dave980/cnc-control-files/cad/dust-extraction/README.md

# Dust extraction

Printable fittings for the shop's dust extraction — hoses, cuffs and adapters.
Separate from the mill's dust shoe, which is in `cad/dust-shoe/`.

3MF rather than STL, so each carries its own print settings.

| File | What |
|---|---|
| `2in-cuff.3mf` | 2 inch hose cuff |
| `2in-to-4in-adapter.3mf` | 2 to 4 inch step |
| `4in-coupler.3mf` | 4 inch coupler |
| `ryobi-cuff.3mf` | cuff for the Ryobi port |
| `ryobi-mitre-saw-hose-adapter.3mf` | mitre saw dust port adapter |

Every file was checked as a valid 3MF before committing: zip container, model
part present, CRCs intact.
