dave980/cnc-control-files/docs/tool-changer.md

# RapidChange ATC

Premium linear magazine, 6 pockets, ER20. `macros/tc.nc` began as RapidChange's
generated macro (see
[rvalotta/RapidChangeATC_FluidNC_M6_Macro](https://github.com/rvalotta/RapidChangeATC_FluidNC_M6_Macro))
and is modified for this machine. Driven through FluidNC's `m6_macro` hook — not the greilick-industries firmware fork, which is a
separate approach that replaces the macro entirely and has no `m6_macro` support.

## Coordinates

All in G53 machine coordinates. Machine Z0 is at the top, at the home switch.

| Tool | X | Y |
|---|---|---|
| 1 | −1211.400 | −85.400 |
| 2 | −1211.400 | −130.400 |
| 3 | −1211.400 | −175.400 |
| 4 | −1211.400 | −220.400 |
| 5 | −1211.400 | −265.400 |
| 6 | −1211.400 | −310.400 |

X and Y are negative because both home switches sit at the +end: X0 at the right-hand
switch (facing the front) with +X to the right, Y0 at the back switch with +Y to the
back. Both axes were flipped on 2026-10-19 so CAM output is not mirrored; before that
every X and Y here was positive, same magnitude.

Pitch 45.000 mm, base Y−85.400. Tool setter sits at **X−1211.000 Y−32.000** — it is
separate hardware that happens to share an X value with the pockets, so pocket
corrections do not move it.

**Manual tool changes happen at X−1100.000 Y−32.000**, 111 mm clear of the
magazine in X. Any tool outside 1-6 — T0, or anything above the magazine's
range — parks there at machine Z0 and waits on `M0`. It used to park at X0 Y0,
the home corner.

Near the magazine, but deliberately not over it, for two reasons. Nothing can
be dropped onto the tool setter, which is the one part here that has already
been broken once. And the working height is better: parked over the magazine
the nose has about 90 mm of clear space beneath it, because the magazine
occupies the bottom 50 mm — over bare spoil board it is the full 140 mm.

Offset in X rather than Y because Y−32 is already near the home end, and moving
the other way in Y runs into the pockets at Y−85.400.

**Machine Z0 is the ceiling.** The axis homes to the top and all travel is
negative from there, so the park is already as high as the machine goes. More
headroom can only come from the XY position, which is what the offset does.

| Z | Purpose |
|---|---|
| 0 | Safe / traverse |
| −68 | Tool recognition zone 2 |
| −74 | Tool recognition zone 1 |
| −82 | Approach, just above the nut |
| −105 | Full engagement |

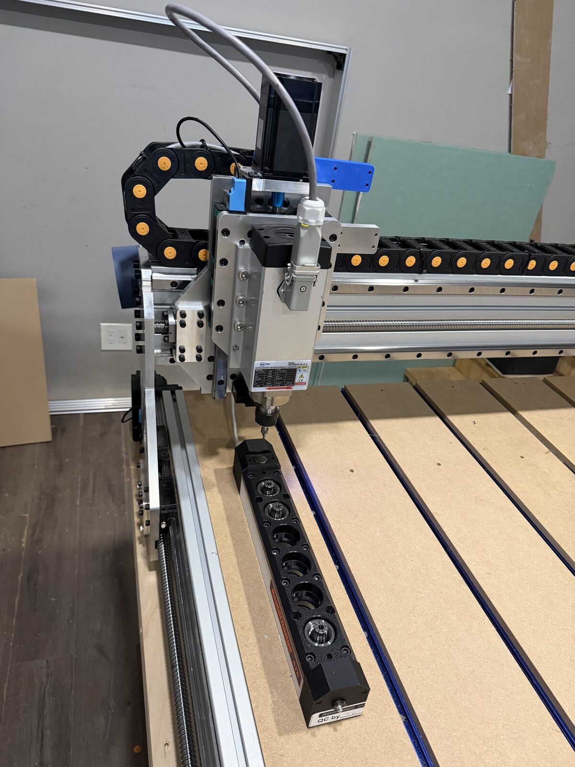
[picture p2: docs/images/spindle-and-magazine.jpg]
Spindle at the magazine


Six pockets in a line along Y, tool setter at the near end. The spindle nose is
at the top of its travel here, which is 90 mm clear of the magazine.

## Z geometry

Measured datums, both from the top of the spoil board:

- Bottom of the spindle, no collet, at Z−115: **25 mm**
- Top of the RapidChange magazine: **50 mm**

So spindle nose height above the spoil board = `25 + (115 + Z)`:

| Z | Nose height | vs magazine top | |
|---|---|---|---|
| 0 | 140 mm | +90 mm | safe / traverse |
| −68 | 72 mm | +22 mm | recognition zone 2 |
| −74 | 66 mm | +16 mm | recognition zone 1 |
| −82 | 58 mm | +8 mm | approach |
| **−90** | **50 mm** | **0 mm** | **clearance plane** |
| −105 | 35 mm | −15 mm | engagement |
| −115 | 25 mm | −25 mm | soft limit |
| −118 | 22 mm | −28 mm | rail end |

**Z−90 is the clearance plane over the magazine.** Above it the spindle passes
over the magazine freely; below it the nose is inside the magazine's envelope.

This verifies the macro geometrically: every XY move in `tc.nc` happens at Z0,
and the lowest the axis goes before an XY move is the −82 approach — both above
−90. The only travel below the clearance plane is the engagement plunge to
−105, which happens stationary over a pocket. Nothing traverses while the nose
is down inside the magazine.

Keep −90 in mind for any hand-written G-code that goes near X−1211. Crossing that
plane anywhere other than directly over a pocket is what a crash looks like.

## Speeds and feeds

| Setting | Value |
|---|---|
| Load | M3 S1800 (~1,830 rpm) |
| Unload | M4 S2100 (~2,130 rpm) |
| Engagement feed | F2000 |
| Probe seek | F600 |
| Probe set | F50 |

**Z travel is 115 mm and the engagement depth is 105 mm.** Ten millimetres of
clearance, which is the tightest margin on the machine. Consequences worth
keeping in mind: there is no room to deepen the pockets, a magazine remount that
sits any lower will not reach, and the soft limit at −115 is the only thing
protecting the bottom of Z since there is no lower limit switch.

**Z `max_rate_mm_per_min` must stay above 2000.** It was at 1500, which silently
clamped every engagement move to 75 % of the designed feed. It is now 2500.

The engagement feed is deliberately slower than synchronous. The ER20 nut is
M25×1.5, so at 1,830 rpm a synchronous feed would be ~2,745 mm/min. F2000 is about
73 % of that, and the shortfall is what makes the spindle thread pull itself into
the nut and seat it.

## Sequence

Load:

1. Rapid to the pocket, Z−82
2. `M3 S1800`, dwell 1 s
3. Four plunges between Z−105 and Z−93 at F2000 — threads the nut
4. `M5`, retract Z−74, read beam — must be **blocked**
5. Z−68, read beam again — must be **blocked**
6. `M61 Q<n>`, then probe the tool setter and `G43.1`

Unload:

1. Rapid to the pocket, Z−82
2. `M4 S2100`, dwell 1 s
3. Plunge Z−105, retract Z−93 — unthreads
4. Z−74, read beam — must be **clear**

## How tool length offsets work

The tool setter's height is never measured and never stored. It does not need
to be, and understanding why explains what can break it.

```
G38.2 G91 Z-75.000 F600.0    seek down fast until the setter trips
G38.4 G91 Z10.000  F50.0     back off slowly until it releases
G43.1 Z[#5063]               tool length offset = that position
```

`#5063` is the probe trip position. FluidNC fills `#5061`-`#5066` from
`steps_to_mpos()`, so it is in **machine** coordinates — the active work offset
cannot leak into the tool length offset.

At the moment of trip the tool *tip* sits at some fixed machine height, call it
T, which is a property of the setter and identical for every tool. The spindle
nose is then at `T + L` for a tool projecting L below the nose, so the offset
stored is `T + L`.

T is unknown and the stored offset is therefore "wrong" — but wrong by the same
constant for every tool, so tool-to-tool differences are exact. The constant
vanishes when work Z zero is touched off: it is absorbed into the G54 Z offset,
and from then on every probed tool puts its tip in the same place.

Accuracy comes from the F50 back-off, not the F600 seek. The seek only has to
land somewhere past the trip point.

### G53 ignores tool length offsets

Worth stating on its own, because it is why the macro works and it is a trap
when typing moves by hand.

`G53` skips the **whole** offset block — work offset and tool length offset
alike. So `G53 G0 Z-105` puts the **spindle nose** at machine Z-105 whatever is
in the collet. Every depth in this file describes the nose, not the tool tip,
which is exactly what the magazine needs: the pockets are at fixed heights and
the engagement depth must not change when a longer tool is fitted.

The same property bites in hand-written code. A `G53` Z move with a long tool
fitted puts the tip however far below the number you typed, and no offset
protects you.

Rule of thumb: **machine-fixed geometry uses `G53`** — pockets, the setter, the
dust shoe stand, park positions. **Cutting uses work coordinates** and plain
`G0`/`G1`, where the tool length offset is applied and the tip goes where the
program means.

`G53` is a modifier, not a motion command: it needs `G0` or `G1` already
active, or FluidNC returns `GcodeG53InvalidMotionMode`. Jogging is a third
thing again — `$J=`, which accepts only G90/G91, G20/G21 and G53.

### What breaks it

- **Touching off work Z zero without a measured tool.** The constant only
  cancels if a tool length offset was active when Z zero was set. Set it with
  no offset, or a stale one, and every tool afterwards is out by the difference.
- **Moving the setter.** Its height is baked into every work offset set since.
  Re-shim it, knock it, or remount the magazine and all existing work Z zeros
  are wrong by that amount, with nothing to indicate it.

Sanity check: the offset is negative, roughly -50 to -80 here, and a **longer**
tool gives a **less** negative value because it trips the setter sooner. A
longer tool reading more negative means something is inverted.

`findzposition.nc` is unrelated to any of this — it creeps up at F250 until the
IR beam breaks, to establish the magazine's tool recognition zones.

### A tool that is already loaded is still measured

`M6` for the tool already in the spindle used to return immediately:

```gcode
o1000 elseif [#<_selected_tool> EQ #<_current_tool>]
    (print, Current tool selected. Tool change bypassed.)
```

That is the first bullet above, reached by accident. The commonest way to hit
it is the ordinary one: power up, `M61 Q3` to tell FluidNC what is in the
collet, load a program whose first tool is 3. The macro bypassed, no probe
ran, no offset was set, and the first touch-off of work Z zero banked whatever
offset happened to be active — usually none.

Now the magazine is skipped but nothing else is. The bypass sets a flag:

```gcode
#<_rc_bypass> = 0
o1050 if [#<_selected_tool> EQ #<_current_tool>]
    #<_rc_bypass> = 1
o1050 endif
```

and the unload and load blocks each open with `if [#<_rc_bypass> EQ 1]`, which
is empty. So the spindle still parks the dust shoe, still clears the old offset
with `G43.1 Z0`, still runs `M61`, still probes the setter, still refits the
shoe and still returns to where the program was. Only the two trips to the
pocket are missing, because the nut never has to be touched.

It measures on **every** same-tool `M6`, not only the first. No state has to be
carried between programs for that, and CAM emits `M6` only at a tool change, so
in a real program the same-tool case *is* the first one. The cost of the extra
measurement is about eight seconds; the cost of not having it is a tool diving
through the work.

## The macro must not end over the tool setter

**This broke a tool and the setter on 2026-10-08.** It is the most dangerous
interaction found on this machine, and it is invisible in hand testing.

The macro used to finish with `G53 G90 G0 Z0.000` and hand control back with
the spindle still parked at X−1211.000 Y−32.000 — directly over the tool setter.
That is safe in itself, since machine Z0 is 140 mm above the spoil board. The
danger is the **next line of the program**.

Vectric emits an initial Z retract at the top of a file, so the first tool
change comes out as:

```
M6 T1
G0Z0.8000        <- work-coordinate Z move, still over the setter
G0X0.0000Y0.0000 <- only now does it move away
```

Z+0.8 inch is 20.3 mm above the work surface. On a 19 mm board that is about
39 mm above the spoil board, and the magazine top alone is 50 mm. The tool is
commanded to a height *below* the thing it is standing on, and gets there at
rapid.

Every later tool change in the same file is safe, because Vectric emits XY
before Z for those. Only the first one carries the trap, which is why hand
testing `M6` never reproduced it — nothing followed with a work-coordinate Z
move.

**Fix: the macro now returns to where it started.** `tc.nc` and
`measuretool.nc` record `#<_abs_x>` / `#<_abs_y>` before any motion and finish
with a `G53` move back:

```
G53 G90 G0 Z0.000
G53 G90 G0 X[#<_rc_start_x>] Y[#<_rc_start_y>]
```

Machine coordinates deliberately, not work. `#<_x>` would have worked too, but
a `G53` return stays geometrically correct even if the work offset is wrong —
and a wrong work offset is exactly the condition under which the next move is
dangerous.

This is a macro-side fix on purpose. Correcting the post would fix one post;
any CAM that emits a Z move before an XY move after `M6` sets the same trap.

### The general rule

**After `M6`, the first move must be XY, not Z.** If you ever write G-code by
hand or change post processors, check that. The machine cannot protect you here
— the soft limit at Z-115 is a machine-coordinate limit and the descent was
well inside it.

## Failure recovery

The macro uses `$Alarm/Send=3` as its abort signal. Alarm 3 is named "Reset while
in motion", which is misleading — nothing reset and no position was lost.

| Message | Meaning | Fix |
|---|---|---|
| Current tool not initialized | `current_tool` is −1 after a restart | `$X`, `M61 Q<n>`, retry |
| IR beam obstructed | Something in the beam at the start | Clear the magazine |
| Failed unload at zone 1 | Tool still on the spindle after unloading | Remove by hand, cycle start |
| Failed load at zone 1 | No tool detected after loading | Thread by hand, cycle start |
| Failed load at zone 2 | Tool detected at −74 but not −68 | Check the nut is fully seated |

Failures pause with `M0`. Fix the condition by hand, then **cycle start** — the
real-time character `~`, or the play button in the web UI.

`~` sent as a *line* from a different interface than the one running the job gets
rejected with "Another interface is busy". FluidNC gates lines needing the
protocol context by channel while a job runs. Send it as a raw character from the
interface that started the job, or use the web UI button.

## Dust cover — not connected

The Premium cover is two servos driven by a programmed ATtiny, with the blue wire
as its logic input. It is an **output** from the controller, not a sensor.

It never worked. What was established:

- gpio.46 (third 5 V output) delivers a clean 5.08 V on pin 2 under `M64 P1`
- The blue wire was confirmed on pin 2
- Unplugging the connector **opens** the cover, so the module idles its input high
- Driving 5.08 V into it does nothing
- The blue wire reads 2.55 V open-circuit — about half rail, a floating input, so
  there is no pull-up to a higher supply

The signal spec is not published. `user_outputs` is removed from the config and
the `M64 P1` / `M65 P1` lines are stripped from `tc.nc` and `measuretool.nc`,
because `M64` on an undefined output errors and aborts the macro.

**The cover has been physically removed from the magazine**, so there is nothing
for a tool to hit. If one is ever refitted, it must be driven or secured open
before running a tool change — `tc.nc` drives Z to −105 in the magazine.
