dave980/cnc-control-files/docs/images/breakout-panel-overview.jpg

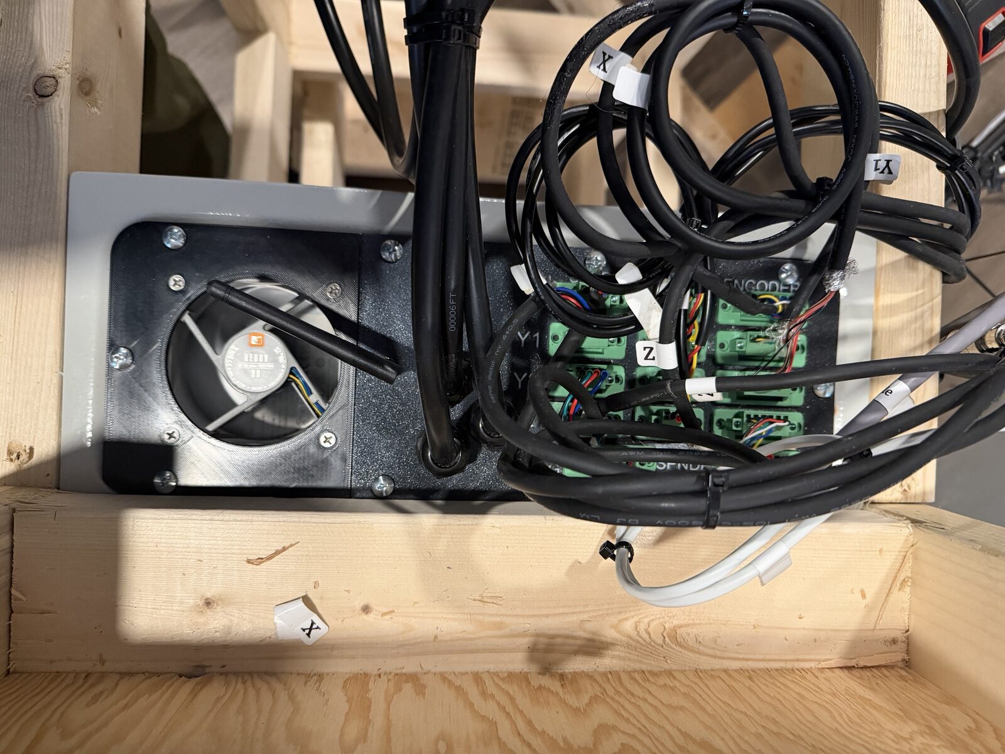
docs/images/breakout-panel-overview.jpg
