dave980/cnc-control-files/docs/images/gantry-overview.jpg

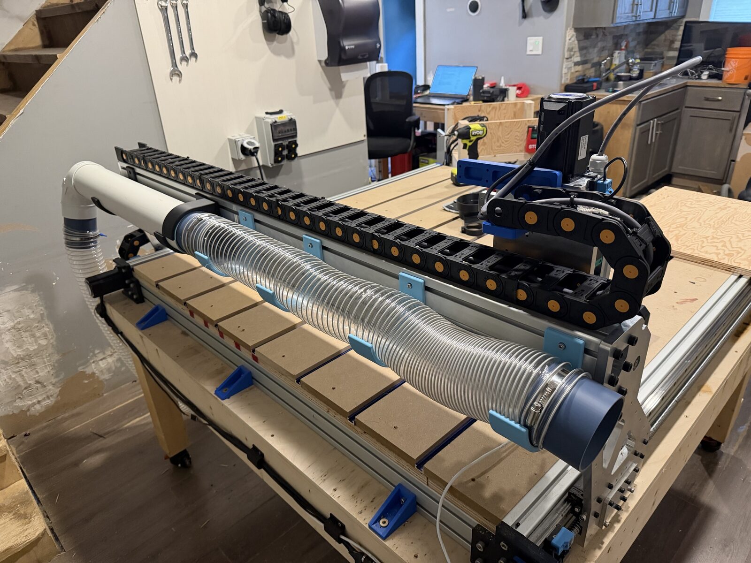
docs/images/gantry-overview.jpg
