dave980/cnc-control-files/docs/images/table-and-gantry-end.jpg

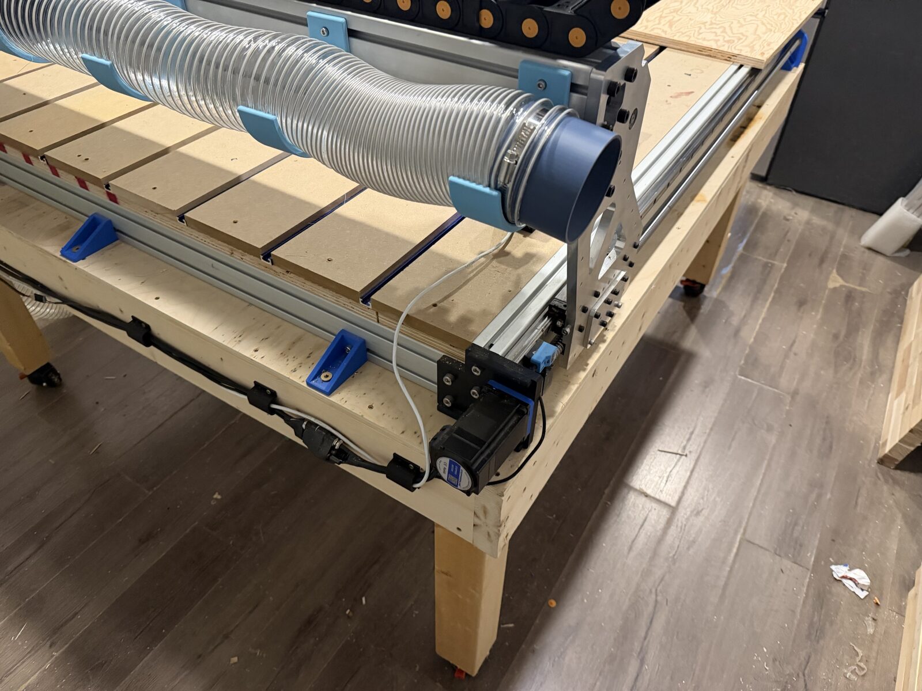
docs/images/table-and-gantry-end.jpg
