dave980/cnc-control-files/docs/images/y-axis-motor.jpg

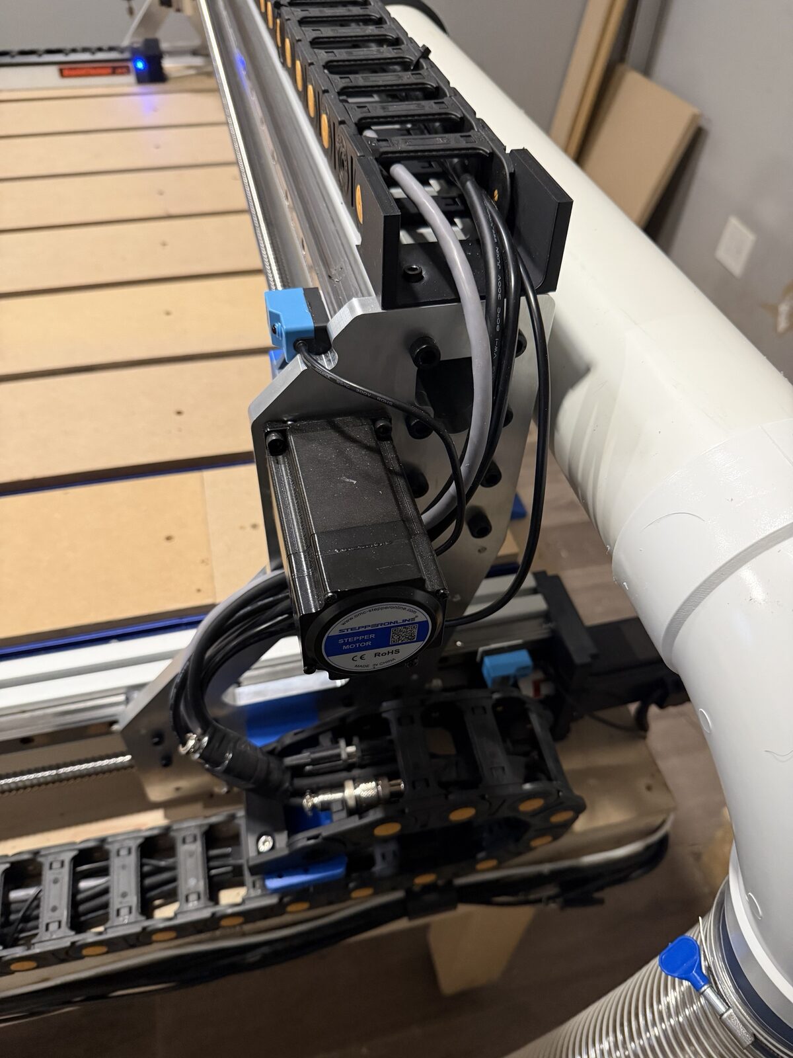
docs/images/y-axis-motor.jpg
