dave980/cnc-control-files/cad/dust-extraction/ryobi-mitre-saw-hose-adapter.3mf

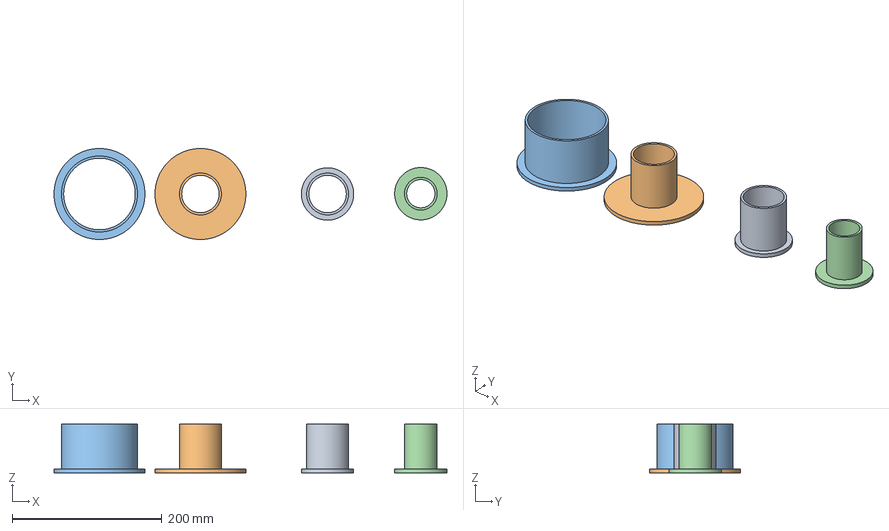
[picture p8: CAD file, 2026-10-25]
cad/dust-extraction/ryobi-mitre-saw-hose-adapter.3mf
525.5 x 121.6 x 65.0 mm
2in coupler
2in to 4in adapter
4in coupler
tool to 2in adapter
