dave980/cnc-control-files/cad/dust-shoe/print/hose-holder-rear.stl

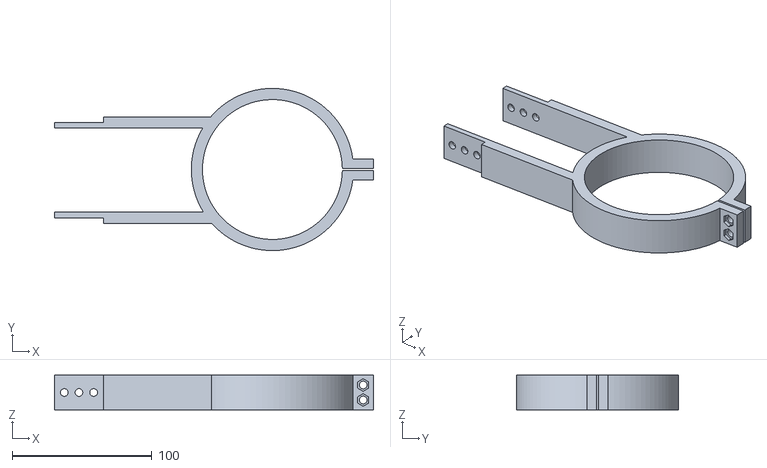
[picture p9: CAD file, 2026-10-25]
cad/dust-shoe/print/hose-holder-rear.stl
228.1 x 116.0 x 25.0
