dave980/cnc-control-files/cad/dust-shoe/stl/solid-brush.3mf

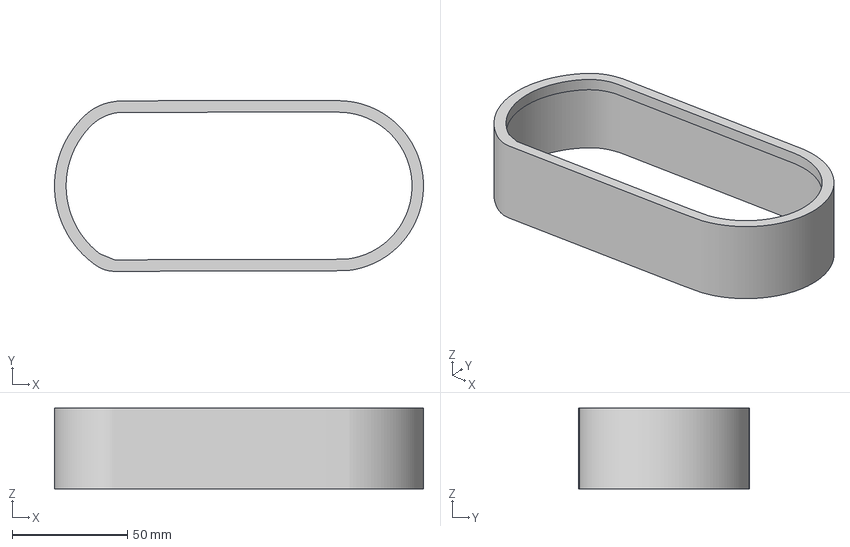
[picture p10: CAD file, 2026-10-25]
cad/dust-shoe/stl/solid-brush.3mf
160.3 x 74.1 x 35.0 mm
