dave980/cnc-control-files/cad/dust-extraction/body36.3mf

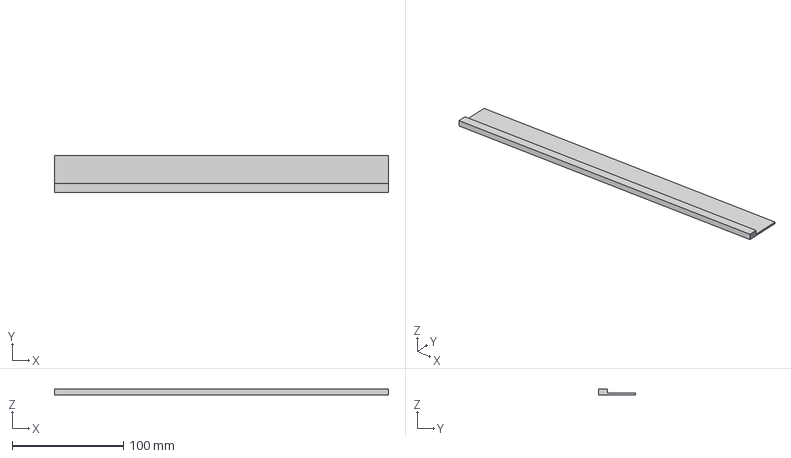
[picture p11: CAD file, 2026-10-25]
cad/dust-extraction/body36.3mf
300.0 x 33.0 x 5.00 mm
