dave980/cnc-control-files/cad/dust-shoe/print/spindle-holder-1.stl

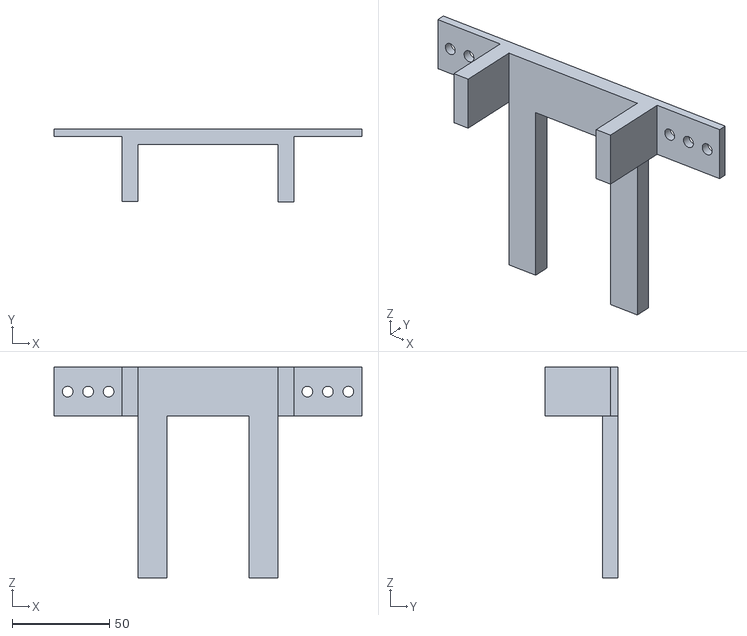
[picture p12: CAD file, 2026-10-25]
cad/dust-shoe/print/spindle-holder-1.stl
158.0 x 37.5 x 108.0
