dave980/cnc-control-files/cad/dust-shoe/stl/2in-to-4in-adapter.3mf

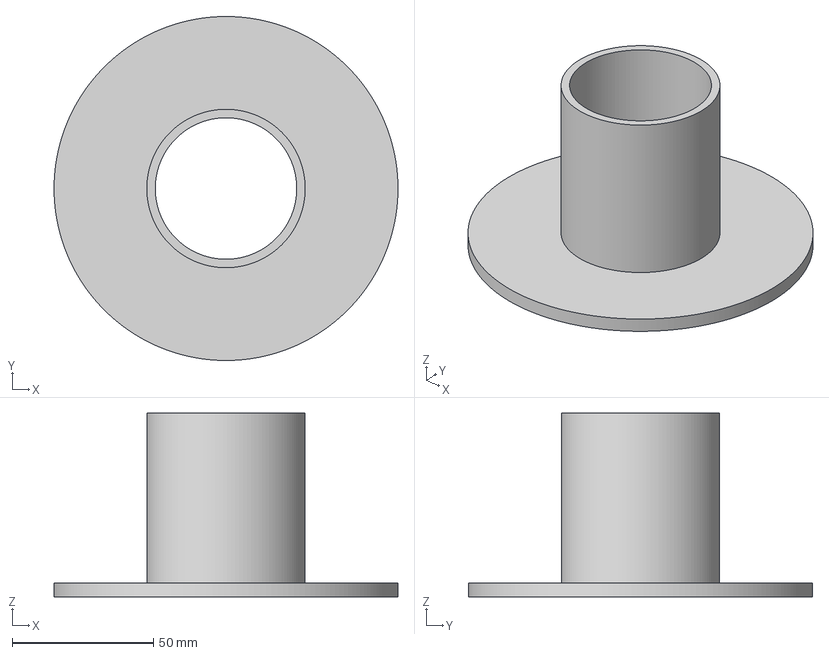
[picture p13: CAD file, 2026-10-25]
cad/dust-shoe/stl/2in-to-4in-adapter.3mf
121.6 x 121.6 x 65.0 mm
