dave980/cnc-control-files/cad/dust-extraction/2in-cuff.3mf

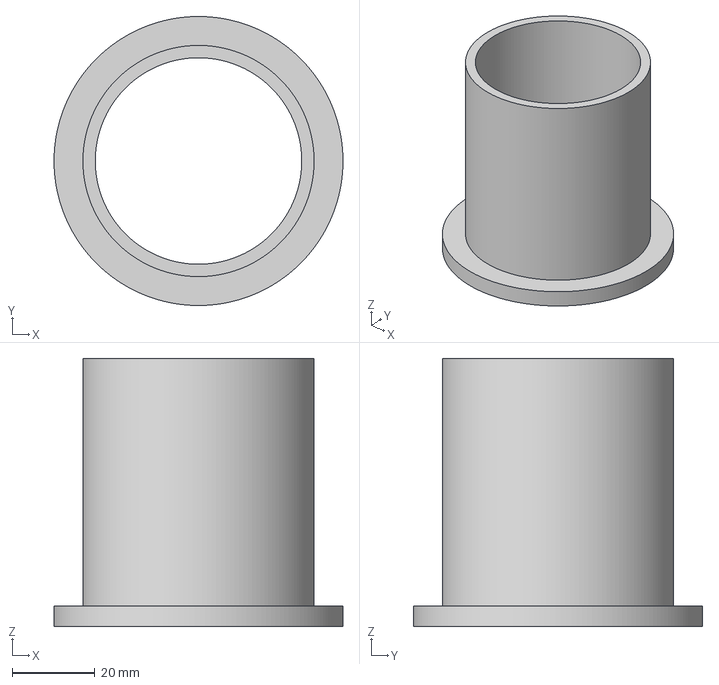
[picture p14: CAD file, 2026-10-25]
cad/dust-extraction/2in-cuff.3mf
70.0 x 70.0 x 65.0 mm
