dave980/cnc-control-files/cad/dust-shoe/print/hose-holder-front.stl

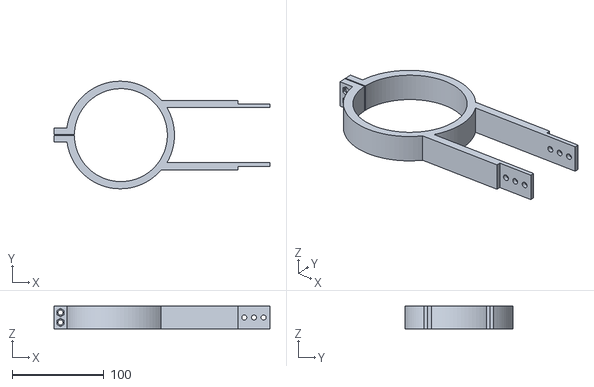
[picture p15: CAD file, 2026-10-25]
cad/dust-shoe/print/hose-holder-front.stl
235.7 x 117.5 x 25.0
