dave980/cnc-control-files/cad/dust-shoe/stl/ryobi-cuff.3mf

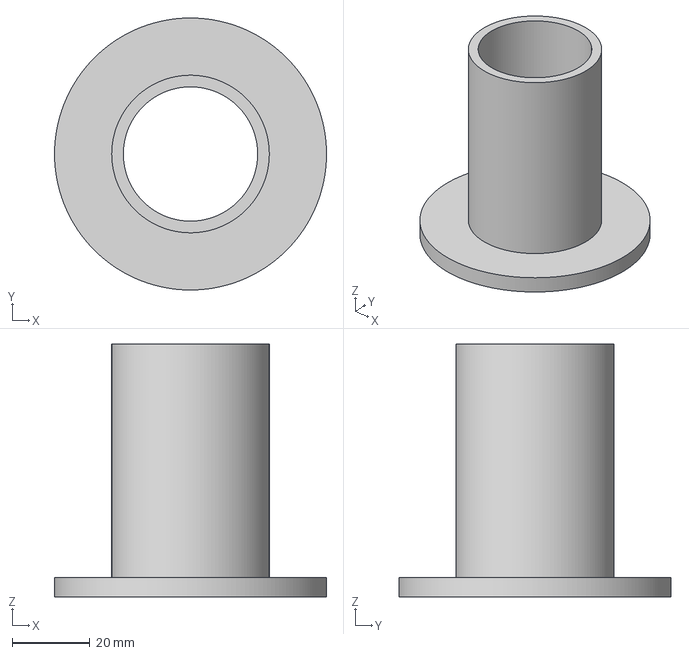
[picture p16: CAD file, 2026-10-25]
cad/dust-shoe/stl/ryobi-cuff.3mf
70.0 x 70.0 x 65.0 mm
