dave980/cnc-control-files/cad/dust-extraction/4in-coupler.3mf

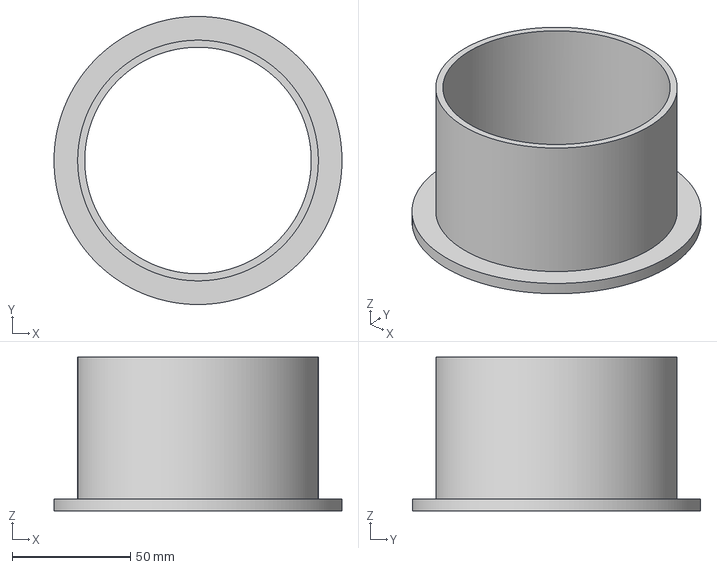
[picture p17: CAD file, 2026-10-25]
cad/dust-extraction/4in-coupler.3mf
121.6 x 121.6 x 65.0 mm
