dave980/cnc-control-files/cad/dust-shoe/stl/bottom-shoe.stl

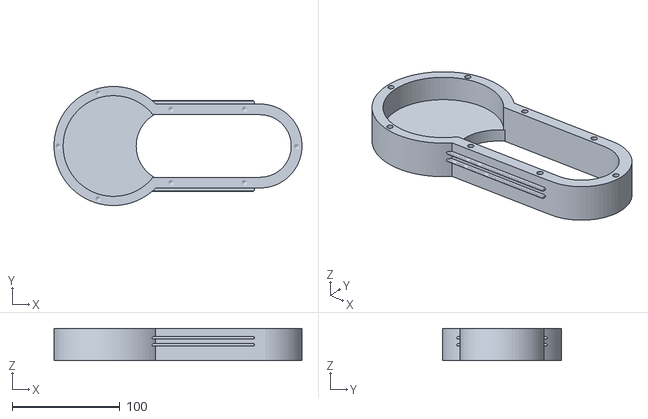
[picture p18: CAD file, 2026-10-22]
cad/dust-shoe/stl/bottom-shoe.stl
230.0 x 110.4 x 30.0
