dave980/cnc-control-files/cad/dust-shoe/stl/body21.stl

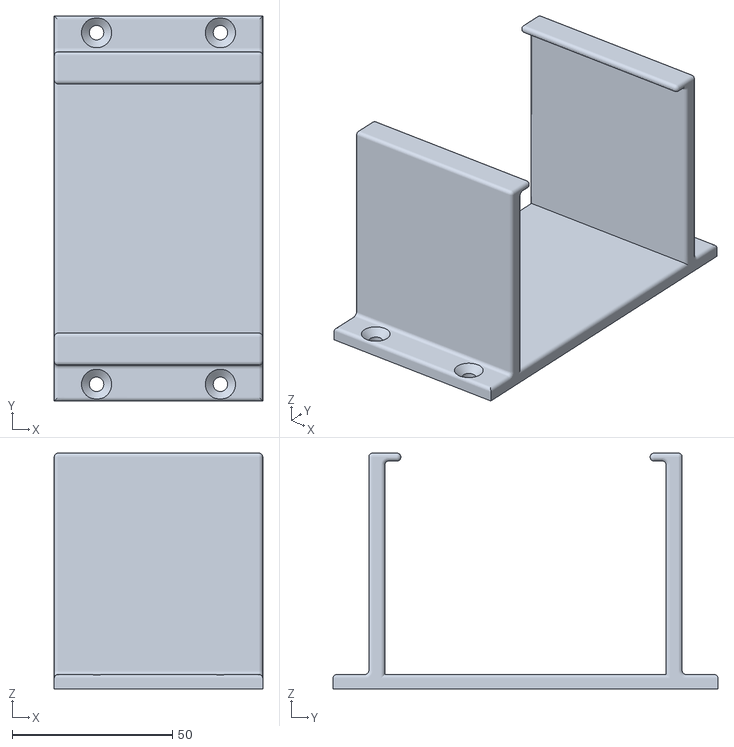
[picture p19: CAD file, 2026-10-22]
cad/dust-shoe/stl/body21.stl
65.0 x 120.0 x 73.5
