dave980/cnc-control-files/cad/dust-shoe/stl/body3.stl

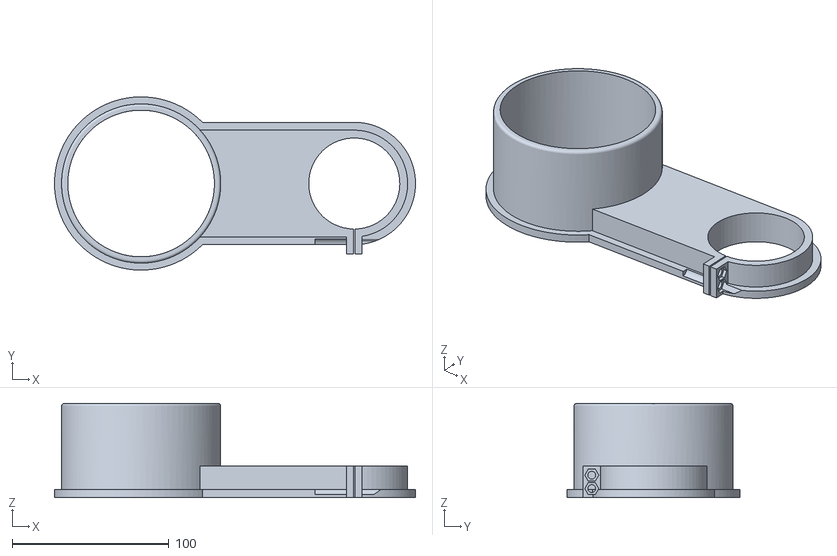
[picture p20: CAD file, 2026-10-22]
cad/dust-shoe/stl/body3.stl
230.0 x 110.4 x 60.0
