dave980/cnc-control-files/cad/dust-shoe/stl/body9.stl

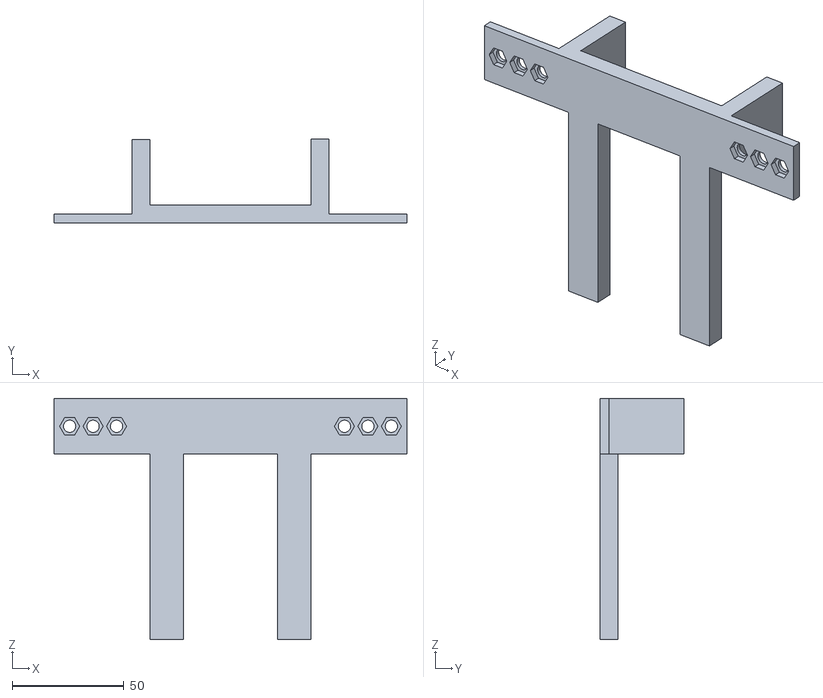
[picture p21: CAD file, 2026-10-22]
cad/dust-shoe/stl/body9.stl
158.0 x 37.5 x 108.0
