dave980/cnc-control-files/cad/dust-shoe/stl/body34.stl

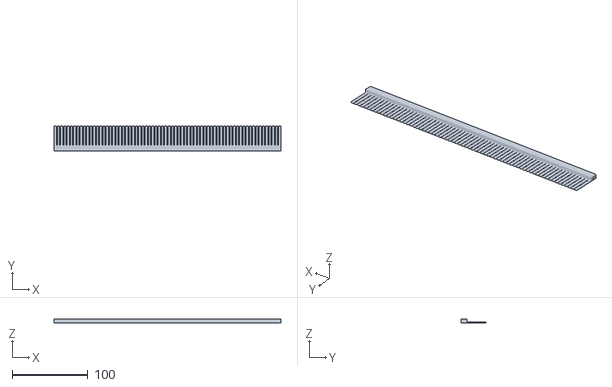
[picture p22: CAD file, 2026-10-22]
cad/dust-shoe/stl/body34.stl
300.0 x 33.0 x 4.75
