dave980/cnc-control-files/(list of files, cad)

Other CAD files:
cad/dust-shoe/stl/body8.stl
cad/dust-shoe/stl/body15.stl
cad/dust-shoe/stl/body27.stl
cad/dust-shoe/stl/body14.stl
cad/dust-shoe/cnc-dust-shoe.f3d
