dave980/cnc-control-files/docs/images/build-in-progress.jpg

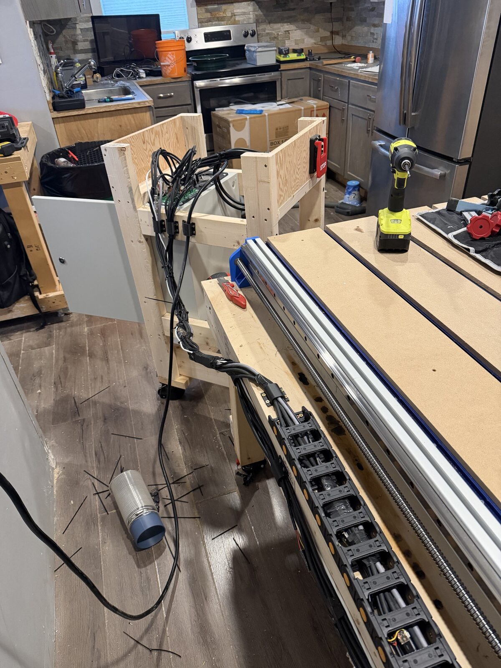
docs/images/build-in-progress.jpg
