dave980/cnc-control-files/(commit log)

2026-10-07 Doberman/FluidNC CNC config with RapidChange ATC
    Working configuration for a 3-axis mill (X, Y1, Y2, Z) on a Doberman board:
    endstops, homing, YL620-A spindle calibration and a RapidChange 6-pocket
    tool changer driven by tc.nc through FluidNC's m6_macro hook.
    Includes commissioning notes for the problems that were non-obvious: the
    opto-isolated input pins, the VFD's low-frequency V/F boost and analog
    floor, the clamped Z engagement feed, and macros living in internal flash
    rather than on an SD card.
    Claude-Session: https://claude.ai/code/session_01YatCWvVEQ2ouZGrFtucrQo
2026-10-07 Shift magazine and tool setter Y by +4.8 mm
    Measured on the machine: pocket 1 moved from Y80.6 to Y85.4 and the tool
    setter from Y27 to Y32. Both shifted by the same amount, so the 45 mm
    pocket pitch is unchanged — this is a whole-assembly offset.
    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
2026-10-08 Rename dobermann_config.yaml to config.yaml
    Board-agnostic name, and references in the README updated to match.
    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
2026-10-08 Corrections from the machine: Y drift fixed, 5 V endstops, cover removed
    - Y drift resolved. The left rail was out of parallel; loosening and
    re-torquing it with the gantry bolted to both carriages fixed it. Moved to
    Solved, with the ruled-out causes kept for the record.
    - Rails are MGN, not HGR.
    - Endstops run at 5 V, not 12 V. The Switch Vcc jumper is global and the tool
    changer needs 5 V, so both share it. Noted that 5 V sits at the bottom of the
    SN04-N range.
    - Dust cover is physically removed from the magazine, so there is nothing for a
    tool to hit. Softened the crash warning to apply only if one is refitted.
    - Magazine pitch left open, rewritten against the current coordinate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
2026-10-08 Correct the SN04-N voltage range
    These are specified 5-30 V DC, so 5 V is in spec at the bottom of the range,
    not below it as the previous note implied.
    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
2026-10-08 Correct rails to HGR20 and record the X/Y linear motion hardware
    X and Y run VEVOR HGR20-1500 rails with RM1605-1500 ballscrews and BF12/BK12
    end supports. The previous MGN reference in the Y drift entry was wrong.
    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
2026-10-08 Record Z rails and note the missing Z max_travel_mm
    Z runs HGR20 300 mm rails with four HGH20CA blocks, so the machine is HGR20
    throughout. Also noted that the Z axis declares no max_travel_mm, leaving the
    bottom of Z without soft limits.
    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
2026-10-08 Record the Z ballscrew and note that Z travel may be tight
    Z uses an SFU1605-350 with BK12/BF12 supports. Added a note that the 300 mm
    rails with two HGH20CA blocks per rail, not the screw, limit Z travel, and that
    the result may not sit far above the 105 mm tc.nc needs.
    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
2026-10-08 Set Z max_travel_mm to the measured 115 mm
    Z travel from the home switch measures 115 mm. Z has only a top limit switch,
    so the soft limit is the only protection at the bottom and it was previously
    unset. Noted the 10 mm of clearance over the tool changer's 105 mm engagement
    depth, which is the tightest margin on the machine.
    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
    [config.yaml]
2026-10-08 Record the reference measurement behind the Z soft limit
    Z-118 is where the carriage sits flush with the bottom of the rail; beyond that
    it overhangs and the balls lose support. The 115 mm soft limit keeps a 3 mm
    buffer before that point.
    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
2026-10-08 Add Z geometry and derive the magazine clearance plane
    Two measured datums from the spoil board — bare spindle nose at 25 mm when Z is
    at -115, magazine top at 50 mm — fix the whole Z geometry. Working it through
    gives Z-90 as the clearance plane over the magazine, which verifies tc.nc: every
    XY move happens at Z0 and the lowest pre-move position is the -82 approach, both
    above -90. Only the stationary plunge to -105 goes below it.
    Also noted that the Z soft limit does not protect the spoil board, since a
    fitted tool reaches it well before -115.
    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
2026-10-08 Add a deploy script for pushing config and macros to the controller
    tools/deploy.sh uploads to the controller's internal flash over FluidNC's HTTP
    API, verified against WebUIServer.cpp: POST /files for LocalFS, with the
    optional <filename>S size field so a truncated upload is caught.
    It refuses to upload unless the machine reports Idle, Alarm or Sleep, since an
    upload mid-job is bad and a $Bye mid-job is worse.
    docs/deploying.md explains why there is no direct GitHub-to-board path, shows
    the self-hosted runner option, and argues against automating the controller
    upload on every push.
    Claude-Session: https://claude.ai/code/session_01Yat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
2026-10-08 Fix deploy.sh argument parsing and the unworkable state check
    Two bugs found on review:
    - Argument parsing mishandled `BOARD=... ./deploy.sh --restart`, taking
    "--restart" as the address. Options and the address are now parsed
    separately, with an error on unknown options.
    - The idle check read the HTTP response of `?`, which never returns anything.
    FluidNC's /command endpoint only returns output synchronously for commands
    starting with [ESP or $/ — everything else goes to the websocket. The check
    would have failed every time and refused all deploys.
    Reachability is now verified with [ESP800], which does return over HTTP and
    confirms the target is FluidNC. Machine state is a hum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
2026-10-08 Add a PowerShell deploy script and Windows notes
    tools/deploy.ps1 mirrors deploy.sh using curl.exe, which ships with Windows 10
    1803+. Same gates: [ESP800] identity check, human confirmation of idle state,
    upload with the size field, then a /files listing.
    Documented that a git repo inside OneDrive is a bad idea — OneDrive syncs .git
    itself and can produce conflicted copies or cloud placeholders — and noted that
    CRLF is harmless here because InputFile::readLine skips \r. .gitattributes pins
    LF regardless, to keep diffs clean.
    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
2026-10-08 Credit the LienCNC-V2 design and the upstream software
    The machine is built from Eric Lien's LienCNC-V2 mechanical design. Credited by
    link rather than by forking, because this repository is not derived from his
    code: LienCNC-V2 ships a UCCNC .pro config while this machine runs FluidNC, so
    the config and macros here share no lineage with it.
    Noted that his repository carries no LICENSE file, so his CAD, drawings and BOM
    are all-rights-reserved by default and must not be copied in here.
    Also credited FluidNC and the Doberman board, RapidChange, and rvalotta's M6
    macro, which tc.nc is based on.
    Claude-Session: https://claude.ai/code/sess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
2026-10-08 Add photos of the machine and wiring
    Ten photos, resized to 1600px and stripped of metadata — 14 MB down to 3 MB.
    Named for what they show rather than their upload hashes.
    Placed where they explain something: the magazine shot in tool-changer.md
    beside the coordinates, the cabinet and breakout panel shots in wiring.md
    beside the pin tables.
    The cabinet photo also pinned down the supply models, which were previously
    recorded only as "48 V" and "12 V": Meanwell XDR-960E-48 and Lawlron NDR-120-12.
    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
2026-10-08 Add photos of the machine and wiring
    Eleven photos, resized to 1600px and stripped of metadata - 15 MB of originals
    down to 3.2 MB. Named for what they show rather than their upload hashes.
    Placed where they explain something rather than in a gallery: the full machine
    leads the README, the magazine shot sits beside the coordinates in
    tool-changer.md, and the cabinet and breakout panel shots sit beside the pin
    tables in wiring.md.
    The cabinet photo also pinned down the supply models, previously recorded only
    as "48 V" and "12 V": Meanwell XDR-960E-48 and Lawlron NDR-120-12.
    Claude-Session: https://claude.ai/code/session_01YatCWvVEQ2ouZG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
2026-10-08 Document the emergency stop, and de-duplicate the docs
    Two commits of the same work landed earlier, leaving README.md with two Credits
    sections and two hero images, and wiring.md with two "The hardware" sections.
    Merged rather than deleted: the Credits section keeps the fuller account of the
    LienCNC-V2 licensing position plus the specific macro modifications from the
    other version.
    The E-stop is hardwired and cuts motor and spindle power while deliberately
    leaving the Doberman powered, which keeps the WebUI and config and avoids the
    current_tool reset. The consequence is that FluidNC does not know it fired, so
    MPos is stale and nothing alarms - hence re-home after every E-stop, noted in
    bot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
2026-10-08 Plan the CL57T alarm wiring on gpio.37
    gpio.37 is free since the dust cover was abandoned, and it is an opto input in
    the same header block as the limit switches.
    Documented that ganging the four ALM outputs depends on their rest state:
    parallel ORs a normally-open output, but would AND a normally-closed one and
    require all four to fault. Series/NC is preferable where supported because a
    broken wire then raises the alarm instead of silently removing the protection.
    Added the control: section to config.yaml commented out, with both polarities
    noted, plus a two-stage test: short the pin to check the config, then force a
    real driver fault.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
    [config.yaml]
2026-10-08 Add a read-only VFD parameter dump over Modbus
    tools/vfd_dump.py sweeps the YL620-A's parameter space over Modbus RTU and
    writes a markdown table. It issues only function code 03, so it cannot change
    the drive's configuration.
    The register mapping is Pgg.ii -> (gg * 256 + ii), which the YL620 manual does
    not document. It is derived from FluidNC's own YL620 driver, which reads two
    registers from 0x0308 and decodes them as min/max RPM - 0x0308 and 0x0309 being
    P03.08 and P03.09.
    CRC16 verified against three canonical Modbus test vectors. The pyserial import
    is deferred so --help works without the dependency installed.
    Claude-Session: htt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
    [vfd_dump.py]
2026-10-08 Record the RS485 adapter used for the VFD dump
    DSD TECH SH-U11F - isolated, FTDI, screw terminals - with the reasoning for
    picking an isolated one in this cabinet, and the wiring detail.
    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
2026-10-08 Note that spindle control stays on 0-10 V, not Modbus
    Bart Dring recommends 0-10 V over RS485 for this board, and the reasoning holds:
    an analog voltage has no protocol to fail, while Modbus control adds a failure
    mode that does not otherwise exist - a dropped link mid-cut leaves the drive
    doing whatever P03.03 dictates. The control registers stay documented for
    reference, with RS485 used only for read-only parameter dumps.
    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
2026-10-08 Record the magazine verified at all six pockets
    All six pockets exercised over repeated tool changes, so the 45.000 mm pitch
    and Y85.400 base are confirmed. The 0.4 mm discrepancy seen earlier between
    pockets 1 and 6 was measured while the Y rail was still binding — it was the
    drift, not a pitch error.
    Move that entry out of Open and repopulate Open with what genuinely remains:
    the CL57T ALM outputs nothing reads, the E-stop FluidNC never hears about, and
    the VFD dump waiting on the adapter.
    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
2026-10-08 Drop the 0.4 mm pocket discrepancy note
    It was poor centring of the spindle over the pocket when the measurement was
    taken, not rail binding, and the pitch was never in question — so the note
    explains nothing worth keeping.
    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
2026-10-08 Correct the ALM wiring for a single-ended alarm pin
    The CL57T brings out one ALM pin, not a floating ALM+/ALM- pair, so the output
    returns through the driver signal common. That rules out the series chain the
    previous note preferred: four single-ended outputs sharing one reference can
    only be paralleled, and parallel fails silent on a broken wire.
    Also note that polarity has to be measured rather than assumed - published
    descriptions of this output contradict each other - and what to do if it turns
    out to source rather than sink.
    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
2026-10-08 Add the ENA/ALM/BRK group common and the 48 V pre-check
    The driver groups ENA, ALM and BRK as single-ended signals, so they share a
    common that the ALM return has to land on - and it is not necessarily the
    step/dir return. Added the check that matters before connecting: if that
    common sits near 48 V it is referenced to the motor supply, and a direct wire
    would put 48 V across a 5 V opto input.
    Also flag BRK, which is adjacent, is also an output, and asserts during normal
    operation - so wiring it by mistake reads as a config fault.
    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
2026-10-08 Record the CL57T pinout from the driver label
    Control connector is PUL+/- DIR+/- ENA+/- ALM BRK COM-, so enable is a
    differential pair and ALM/BRK are the only single-ended signals, with COM- as
    their shared emitter common. That settles the return path: ALM to gpio.37,
    COM- to the input header GND.
    Two things this changes. COM- is the driver's internal logic common and
    probably the power ground, so wiring it to the Doberman may bond the 48 V
    negative to logic ground - a star-ground decision, not just a signal. And the
    fail-safe question is not series-vs-parallel but which way the output rests:
    conducting-when-healthy is the fail-safe sense but ANDs rather than ORs when
    paralleled, which nee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
2026-10-09 Replace the ALM meter test with a firmware read
    A voltmeter cannot resolve an open-collector output with nothing pulling it
    up, and an ohmmeter on a powered circuit is unreliable - so the documented
    meter test would not have answered the question. gpio.37 already has the
    pull-up needed: wire one driver, read it through user_inputs with M66, force
    an alarm, read again.
    Reading it as a plain input rather than fault_pin keeps the test repeatable -
    fault_pin raises a critical alarm that only a soft reset clears, and that
    resets current_tool to -1.
    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
2026-10-09 Fix the stale COM- claim in the ALM intro
    The intro predated the driver label and said the alarm returned through the
    common the step/dir pairs already share. It does not - COM- is its own
    terminal and needs its own wire. Also stop presenting parallel as settled,
    since whether it ORs or ANDs depends on a measurement not yet taken.
    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
2026-10-09 Explain how tool length offsets work
    The tool setter's height is never measured or stored. Records why that still
    gives exact results - the trip height is a constant common to every tool, and
    it is absorbed into the work offset when Z zero is touched off - and the two
    things that break the chain: touching off Z zero without a measured tool, and
    moving the setter after work offsets exist.
    Confirms from FluidNC's Parameters.cpp that #5061-#5066 come from
    steps_to_mpos(), so the probe result is in machine coordinates and the active
    work offset cannot contaminate the tool length offset.
    Claude-Session: https://claude.ai/code/session_01YatCW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
2026-10-09 Return to the starting XY instead of parking over the tool setter
    A program's first M6 broke a tool and the setter. tc.nc finished with the
    spindle still at X1211 Y32, over the setter, and Vectric emits an initial Z
    retract before any XY move - so the next line, G0 Z0.8, drove the tool back
    down into the setter at rapid. Z+0.8in is ~39mm above the spoil board on a
    19mm board; the magazine top alone is 50mm.
    Only the first tool change in a file is exposed, since later ones emit XY
    first. That is why hand-running M6 never reproduced it.
    tc.nc and measuretool.nc now save #<_abs_x>/#<_abs_y> before any motion and
    return there with G53 after retracting. Machine coordinates on purpose: the
    retur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
2026-10-11 Add --list to vfd_dump.py and explain Windows error 121
    Opening COM5 failed with 'The semaphore timeout period has expired' - error
    121, raised at open() before anything reaches the VFD, so it is a host/adapter
    fault and not a wiring, baud or polarity one.
    --list prints the ports actually present with USB vendor IDs, which separates
    a wrong COM number from a ghost registry entry from a USB fault. The open
    failure now also catches OSError (121 arrives as OSError, not SerialException,
    so it was previously an untrapped traceback) and prints what to check.
    Both paths tested against a stubbed pyserial, since it cannot be installed in
    this environment.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
    [vfd_dump.py]
2026-10-11 Record COM3 as the adapter, and Bluetooth ports as the error 121 cause
    COM5 was a 'Standard Serial over Bluetooth link'. Windows tries to raise an
    RFCOMM connection to a device that is not paired, waits, and times out - which
    is exactly how error 121 surfaces. Those ports exist whether or not anything
    is paired, so they look like real candidates.
    The SH-U11F is COM3 on this laptop, 0403:6001.
    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
2026-10-11 Add .gitattributes to pin line endings
    The working copy is Windows but deploy.sh runs under bash, where CRLF makes
    the interpreter line unparseable. Pin .sh to LF, .ps1/.cmd to CRLF, and the
    files that get uploaded to the controller to LF.
    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
2026-10-11 Correct four VFD values against the dump, and flag the overload setting
    P06.01/P06.02 were recorded as 9 s and 8.6 s and P12.19 as 13 kHz. The drive
    holds 5.0 s, 5.0 s and 8.0 kHz - the earlier numbers were the setup table's
    suggestions copied in rather than read off the drive. The machine was always
    right; only this file was wrong.
    The dump also confirms what could not be verified before: P00.04 = 4000
    validates the register mapping and 0.1 Hz scaling independently, P03.12 = 0
    confirms the low-speed fix on the drive, P07.08 = 3 confirms analog input 1 is
    the frequency source, and P12.02 = 2 poles is what makes 400 Hz = 24000 rpm.
    Flagged but not changed: P12.00 rated motor current reads 1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
    [vfd_dump.py]
2026-10-11 Nameplate says 6 A: P12.00 is set at 15.0 A, 2.5x the spindle rating
    Photographed the spindle nameplate. 220 V, 400 Hz, 24000 rpm, 2.2 kW, 6 A,
    2 poles - the poles and the V/F figures match the drive, the current does not.
    P12.00 holds 150 (15.0 A), the same as P12.05 the converter rating, so the
    motor figure was evidently never set.
    That leaves the thermal overload unable to act before the windings are in
    trouble, and it matters most at the bottom of the range where the 20% V/F
    boost pushes current through a spindle whose fan is barely turning.
    Recorded the fix but did not touch P12.01 or P01.04: rated motor voltage
    scales the V/F curve on this kind of drive, and shifting it would disturb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
2026-10-11 P12.00 corrected to 6.0 A, units confirmed on the panel
    The panel reads 6.0, which also settles the 0.1 A scaling for this parameter -
    it had been inferred from P12.05 rather than documented.
    Moves the VFD dump out of Open, since it is done and cross-checked, and
    replaces it with the two things it left behind: a tool change has not been run
    since the overload was tightened 2.5x, and vfd-parameters.md still records the
    old 150.
    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
2026-10-11 P12.00 at 6.0 A stops the spindle starting - reverted
    Setting the rated motor current to the 6 A nameplate value left the spindle
    unable to turn at all on a tool change. P12.00 is not only a thermal
    threshold: P01.03 and P01.04 are percentages of it, so 140% and 200% fell
    from 21 A and 30 A to 8.4 A and 12 A. An induction motor needs several times
    rated current to break away, so the drive clamps before the spindle develops
    starting torque.
    That was missed when the change was recommended - P12.00 was treated as one
    protection value rather than the scaling base for the whole group.
    The underlying problem stands: at 15.0 A the overload cannot protect a 6 A
    spindle. A real fix has to raise the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
2026-10-11 Err11 is motor overload: correct the mechanism and add the fault code table
    The drive reported Err11, motor overload - the overload model, not an
    overcurrent clamp. The earlier explanation blamed P01.03/P01.04 and was wrong.
    P01.05 is the overload threshold as a percentage of P12.00: 130% of 15.0 A is
    19.5 A, but 130% of 6.0 A is 7.8 A, which a 2.2 kW spindle exceeds getting
    moving.
    That also means the drive cannot both allow a boosted low-speed start and
    protect a 6 A motor, since one percentage governs both - raising P01.05 to
    permit the start gives most of the protection back. Recorded an intermediate
    P12.00 and a clamp-meter measurement as the honest options.
    Added the manual's fault c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
2026-10-11 P12.00 stays at 15.0 A: the nameplate value cannot be used
    10.0 A failed to start as well as 6.0 A. Three data points put the starting
    requirement between 13 A and 19.5 A - two to three times the 6 A nameplate,
    which is ordinary for an induction motor. What matters is that the drive's
    overload trips on it despite P01.06 nominally allowing 120 s, so it is not a
    slow thermal integral and cannot be set near the nameplate.
    One parameter serves both the starting allowance and the sustained limit, and
    the start sets a floor around 15 A. The V/F boost that made tool-change speeds
    possible is what drives the current, so backing it off would trade the
    low-speed capability the tool changer depends on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
2026-10-14 Record that only one opto input is free, and how to wire the ALM
    gpio.37 is the only free input - 36 is the probe, 38 the IR beam, 39-42 the
    limits, and the 5V outputs sit behind a buffer and cannot be read. So
    fault_pin and estop_pin cannot both have a pin, which the previous snippet
    implied they could.
    The ALM gets it: a driver faulting on position error is invisible to FluidNC
    today, while the E-stop already cuts power and signalling it only corrects the
    position display afterwards.
    Added the physical wiring, and why sharing the pin costs the fail-safe
    property - an NC E-stop contact rests closed and opens on press, the opposite
    sense to an ALM that pulls low on alarm, so sharing forces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
2026-10-15 Manual tool changes happen over the tool setter, not at X0 Y0
    Both out-of-range branches in tc.nc parked at the home corner. They now park
    at X1211.000 Y32.000, over the setter, which is where the macro probes
    immediately afterwards - so a hand-fitted tool is measured without moving and
    nothing traverses with a tool of unknown length.
    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
2026-10-15 Offset the manual change park 111mm clear of the magazine
    X1100 Y32 rather than directly over the tool setter. Nothing can be dropped
    onto the setter, and the usable height improves: over the magazine the nose
    has ~90mm beneath it since the magazine occupies the bottom 50mm, where over
    bare spoil board it is the full 140mm.
    Offset in X because Y32 is already near the home end and the other direction
    runs into the pockets at Y85.4.
    Z was already at the ceiling - machine Z0 is the top of travel - so the extra
    headroom could only come from the XY position.
    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
2026-10-19 Add dust shoe CAD: Fusion archive and per-body STLs
    Claude-Session: https://claude.ai/code/session_01EaHTYpXKr5mP7WEdGgcA2C
2026-10-19 Add dust shoe load/unload macros
    Magnetic shoe parks in the spoil-board stand: unload slides it onto the
    flanges and lifts off the magnets, load descends slowly and slides out.
    Positions are placeholders; both macros alarm until ds_park_x is set.
    Load pauses on M0 for a person to confirm the shoe is in the stand.
    Wired to WebUI macro buttons 2/3 and added to both deploy scripts.
    Claude-Session: https://claude.ai/code/session_0154KYwruiBaGSwdv9L3aWzM
2026-10-19 Dust shoe: stand is at X1210 Y610, slide is along Y
    Corrected: the shoe slides along Y from Y730 to Y610 at X1210, not along
    X. The whole 120 mm slide is now at F1000; the rapid-then-feed approach
    was only needed for the old 600 mm move.
    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
2026-10-19 Dust shoe macros: fix two broken slide lines; correct how they're run
    The previous edit's regex joined the slide move onto the line above in
    both standalone macros, leaving an unbalanced expression. Restored them
    as single G1 slides. Also corrected the docs: macro2/macro3 are FluidNC
    numbered macros run with $Macros/Run=N, not WebUI buttons.
    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
2026-10-19 Dust shoe: engage Z -87.5 (was -90)
    Slide height and magnet-seat height corrected to Z -87.5; the 15 mm
    slow lift/descent now runs between -87.5 and -72.5. Same change in
    tc.nc and both standalone macros.
    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
2026-10-20 Flip Y so +Y points to the back (fixes mirrored Vectric output)
    Y homed to the back as Y0 with +Y toward the operator, which made the
    machine's XYZ the mirror of CAM's convention: every Vectric job came out
    mirrored front-to-back. Now:
    - Y homing positive_direction: true, still mpos 0 at the back switches
    - Y1/Y2 switches moved from limit_neg_pin to limit_pos_pin (same wiring)
    - Y1/Y2 direction pins uninverted (dropped :low)
    - Every G53 Y in tc.nc, measuretool.nc and the dust shoe macros negated:
    pockets -85.4..-310.4, setter/manual change -32, shoe -610/-730.
    Same physical positions.
    - Docs updated; envelope is now X 0..1220, Y 0..-1200, Z 0..-115.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
2026-10-20 Flip X as well: +X right, +Y back, facing the front
    The X switch is on the right as you face the machine, so +X ran left.
    With the earlier Y-only flip that left the machine mirrored. Now:
    - X homing positive_direction: true, mpos 0 at the right-hand switch
    - X switch moved from limit_neg_pin to limit_pos_pin (same wiring)
    - X direction pin uninverted (dropped :low)
    - Every G53 X in tc.nc, measuretool.nc and the dust shoe macros negated:
    pockets -1211.4, setter -1211, manual change -1100, shoe -1210.
    - Envelope X 0..-1220, Y 0..-1200, Z 0..-115; all axes home positive.
    Claude-Session: https://claude.ai/code/session_0154KYwruiBaGSwdv9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
2026-10-20 Spindle: off_on_alarm true; log false X hard-limit trip
    A spurious X limit trip mid-job stopped the axes but left the spindle
    running at 18000 rpm. Any alarm now also stops the spindle.
    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
2026-10-20 Docs: false X limit trip traced to a bad X sensor wire, fixed
    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
2026-10-22 Document jog soft-limit behaviour - it differs from program moves
    The overrun was a jog, and jogs take constrain_jog() rather than
    invalid_line(): a program move out of range is rejected whole, a jog is
    clamped and simply stops at the boundary with no alarm.
    Outside the envelope the rules change again - further-out jogs are cancelled
    unless a switch is active, and then capped at the pull-off, which is
    unset here so FluidNC's 1.0mm default applies.
    All of it logs at Debug and nothing higher, so at the default message level a
    clamped or cancelled jog looks like a jog that did nothing - the same trap
    that stretched out the M6 hunt.
    Claude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
2026-10-22 Note that G53 ignores tool length offsets
    It is why the magazine depths are correct for every tool - they describe the
    spindle nose, not the tip - and it is the trap when typing G53 Z moves by hand
    with a long tool fitted.
    Also records that G53 is a modifier needing G0/G1 active, and that jogging is
    a separate path via $J=.
    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
2026-10-22 Add a surfacing program generator
    tools/surface.py writes a flattening program from length, width and depth.
    Raster along X, stepping over in Y, alternating direction, with the cutter
    overhanging every edge by its radius plus a lead so nothing is left proud at
    the boundary, and the plunge happening off the corner in air.
    Depth and stepover are both distributed evenly rather than leaving a thin
    final pass - 1.5mm at 0.5 max becomes three passes of exactly 0.5, and a 300mm
    width with a 10.16mm maximum becomes 30 of exactly 10.0.
    Coverage was verified rather than assumed: the generated path was checked
    against a 0.5mm grid over the full board with no uncovered points, and the
    deepest Z confir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
2026-10-22 Surfacing: account for insert corner radius, and say tool diameter is unknowable
    The flat part of a cutter with rounded inserts is tool_dia - 2R, and that, not
    the diameter, is what limits stepover. --corner-radius computes the ridge left
    between passes from the corner arc, and refuses outright when the stepover is
    wide enough that the periphery cannot reach between passes.
    The default 0.4 stepover is far inside the limit so normal use is unchanged;
    this matters when pushing stepover up to shorten a long job, which is when
    tramlines appear for no obvious reason.
    Also documented that nothing on the machine knows tool diameter - FluidNC has
    no tool table, M61 records a number and the setter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
2026-10-22 Surfacing: prompt for values, and a double-clickable launcher
    Run with no options and it asks for everything, Enter accepting each default.
    Bad combinations re-prompt with the previous answers as defaults rather than
    quitting. Both routes produce byte-identical output - verified by diffing the
    prompt-driven file against the flag-driven one - and the coverage check still
    passes over the full board.
    tools/surface.cmd is the double-clickable front end for Windows, finding
    python or py and pausing so the summary stays readable.
    For a machine without Python, .github/workflows/surface-exe.yml builds a
    standalone surface.exe on a Windows runner, since PyInstaller cannot
    cross-compile. It smoke-te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
2026-10-22 Tidy: untrack bytecode, fix deploy.cmd restart flag, widen .gitignore
    The .pyc files under tools/__pycache__ were committed by accident when I used
    git add -A after importing surface.py in a test. They regenerate on every run
    and will show as modified forever, so they are untracked now and ignored.
    deploy.cmd had been edited locally to always restart the controller, which is
    a sensible default, but with '--restart'. deploy.ps1 declares [switch]$Restart,
    so PowerShell would have rejected '--restart' as an unbindable positional
    argument and the deploy would have failed. Now passes -Restart.
    .gitignore also now covers generated programs at the repo root, scoped as
    /*.nc so the tracked macros/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
2026-10-22 Update dust shoe CAD: re-exported from Fusion, plus a new Body34
    Fresh .f3d and per-body STLs exported 2026-10-22.
    The seven existing bodies have identical bounding boxes to the previous
    export, so the envelope is unchanged - the meshes themselves differ (Body3
    dropped from 724 KB to 402 KB), so this is refined geometry rather than a
    resize.
    Body34 is new: 300.0 x 33.0 x 4.8 mm.
    All eight STLs were checked as valid binary STLs - header triangle count
    matching file length - and the .f3d verified as a readable archive container
    before committing, since a truncated CAD export is not obvious by eye.
    Bounding boxes in the README are now measured from the STL geometry rather
    than transcribed.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
2026-10-22 Name the dust shoe parts instead of body3, body8, body27
    Renamed from Fusion body numbers to what the parts actually are: top shoe,
    bottom shoe, shoe brush, shoe dock, hose holder front/rear, spindle holder
    1/2. Done with git mv so history follows each file.
    Every STL is byte-identical to the one it replaces - verified by sha256
    against the previous export before renaming - so this is naming only, no
    geometry change. The .f3d itself does change, since the body names live
    inside the archive.
    The README now carries both the part table and the old body numbers, so an
    STL printed from the earlier export can still be identified.
    Claude-Sess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
2026-10-22 Correct the claim that only one input pin exists
    That was overstated - it was true of the opto-isolated block, which is all
    that had been confirmed, and got written as though it were true of the board.
    Other GPIO may well be free, in which case fault_pin and estop_pin can have
    one each.
    Added what actually matters once a second pin is in play: an opto input and a
    raw ESP32-S3 pin are not interchangeable, so the ALM - unisolated, possibly
    referenced to the 48 V negative, on a wire beside motor cables - belongs on
    gpio.37, and the E-stop's dry contact on the raw pin.
    Claude-Session: https://claude.ai/code/session_01YatCWvVEQ2ouZGrFtucrQo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
2026-10-22 The opto input block is ten pins, not seven - four are free
    Read off the silkscreen: GPIO.42 41 40 39 38 37 36 48 47 3. I had the block as
    the contiguous 36-42 range and never knew 48, 47 and 3 were on the end, then
    asserted twice that only one input was free and that fault_pin and estop_pin
    could not both have one. Both wrong - 37, 48, 47 and 3 are free, and all ten
    are optocoupled.
    That also settles the ALM grounding worry: whatever COM- is referenced to,
    there is an optocoupler between it and the microcontroller.
    gpio.3 is flagged for last. It is an ESP32-S3 strapping pin (JTAG source
    select), as are 0, 45 and 46 - which is why the board spends 45 and 46 on the
    5 V outputs. An input ass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
2026-10-22 Note the ALM measurement has not been done
    Searched the prior conversations: gpio.37 appears only as reserved for the
    driver alarms, never wired or metered. The meter check on record is the
    SN04-N endstops - same board, same kind of measurement - which is probably
    what it gets confused with. Recorded so this is not re-litigated.
    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
2026-10-24 COM- is not the driver power ground - series chaining may be available
    Measured: COM- shows no continuity to the driver's GND power terminal, so the
    ALM output side is isolated from the 48 V supply rather than referenced to it.
    Two consequences. The ground-bonding concern is gone - wiring COM- to the
    input header GND does not tie the supplies together, and a meter from a
    floating COM- to board ground reads nothing meaningful, so that check is
    dropped.
    And the claim that a series chain was impossible was wrong. It rested on the
    four drivers sharing COM- as a common ground. If each ALM/COM- is an
    independently floating pair they chain like dry contacts, which is the
    fail-safe arrangement - a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
2026-10-24 Finish the series-chain correction in the two passages the last edit missed
    An assertion failed mid-edit, so the fail-silent paragraph and the outcome
    table still said a series chain was unavailable and that conduct-when-healthy
    needs a PC817 per driver. Both now reflect that an isolated COM- makes the
    chain possible, with the optocoupler workaround kept only for the case where
    the COM- pins turn out to be commoned.
    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
2026-10-24 Drop the voided COM- voltage check, record what was measured
    COM- shows no continuity to the driver's power GND, so the output side is
    isolated from the 48 V supply and the star-ground advice no longer applies.
    Removed the DC-volts-to-board-ground step. It is void twice over: the question
    it asked is already answered, and a voltmeter on a floating node reads stray
    coupling rather than a potential, so it never could have answered it.
    States plainly what remains unmeasured - whether the four COM- pins are
    independent of each other - since that is the one reading that decides the
    topology.
    Claude-Session: https://claude.ai/code/session_01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
2026-10-24 The four COM- pins are independent - both topologies available
    OL between COM- on two drivers, so each ALM/COM- is its own floating pair and
    they can be wired in series or parallel like dry contacts. The polarity now
    decides which, rather than parallel being forced.
    Only the series case is fail-safe, and no wiring makes the parallel case so -
    a contact resting open cannot report its own broken wire.
    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
2026-10-24 ALM rests open: parallel wiring, fault_pin gpio.37:low
    Measured on the Z driver. Healthy reads 0; bridging the ALM and COM- wires
    reads 1. The bridge is what makes the 0 meaningful - it proves the pin, the
    :low attribute and the two wires' landing points at once. Without it a healthy
    0 cannot be told apart from a circuit that was never connected, which is what
    the first three readings actually were.
    Logged the part that is still unexplained: with the encoder unplugged at the
    driver and the axis commanded to move, it moved and never raised its alarm.
    That has implications past this wire - if the driver is not closing the loop
    then the Y drift entry's claim that these correct error rather tha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
2026-10-24 SW6 is the closed/open loop switch - likely why the driver never alarms
    Read off the driver label: SW6 off = Control Mode Close, on = Open. With it on
    the encoder is ignored, position error is never computed and ALM cannot assert,
    which matches the encoder-unplugged test producing no alarm. Confirmed from a
    close-up that the red PWR/ALM LED is genuinely unlit, so the driver is not
    alarming rather than alarming into a dead wire.
    Also flagged S1: the dial sits between the 9 and A detents, and 9 gives 4 A RMS
    against the motor's 5 A rating - about 20% down on torque.
    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
2026-10-24 SW6 is on: the Z driver is running open loop
    Read off the switch bank with ON as the down position: SW1-4 on/off/on/on
    (1600 pulse/rev, which matches steps_per_mm 320 on a 5 mm lead), SW5 off, SW6
    ON, SW7 off, SW8 on. SW6 on is Control Mode = Open, so the encoder is wired and
    ignored.
    That accounts for the entire ALM investigation: with no closed loop there is no
    position error to detect, so the driver cannot alarm and the fault_pin wiring
    protects nothing until the switch is changed.
    It also undermines a premise recorded during the Y drift hunt - that these
    drivers correct error rather than losing steps silently. An open-loop driver
    does neither. The rail was genuinely out of parallel and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
2026-10-24 SW6 off on all four drivers; S1 confirmed at A
    The machine is closed loop for the first time. S1 is on A - 7.0 A peak, 5 A
    RMS - which is correct for the 24E1K-30 rather than the 9 the photo left
    ambiguous.
    First symptom after the change: the Z driver's ALM blinks red when Z moves.
    Logged pending diagnosis; the encoder having been left unplugged from the
    earlier test, and the encoder counting opposite to the motor, are the first
    two candidates.
    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
2026-10-24 Driver alarms wired and proven: fault_pin gpio.37:low
    Three readings settle it - 0 healthy, 1 with ALM and COM- bridged by hand, 1
    with the driver genuinely alarmed. The bridge reading is what makes the first
    one mean anything; without it a healthy 0 is indistinguishable from a circuit
    that was never connected, which the first few readings turned out to be.
    The driver would not alarm at all until SW6 came off, because open loop
    computes no position error. With it off, pulling the encoder and commanding a
    move alarmed immediately and gpio.37 followed.
    Promotes gpio.37 from the temporary user_inputs test pin to control.fault_pin
    and records the remaining free opto inputs for estop_pin.
    Co-A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
2026-10-24 Note the ALM wiring is in but unverified and undeployed
    Four ALM joined to the signal pin, four COM- to GND. Still to do: meter the
    input high before deploying, deploy and restart, then prove each driver
    individually by pulling its encoder.
    The per-driver test is the one worth not skipping. Parallel hides a dead wire
    behind the other three, and only one of the four has ever been demonstrated to
    reach the controller.
    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
2026-10-25 Add the printable 3MF dust extraction fittings
    Seven 3MF models: hose cuffs, a 2-to-4 inch step, a 4 inch coupler, Ryobi
    fittings, a solid brush, and body36. Each verified as a valid 3MF - zip
    container, model part present, CRCs intact - before committing.
    Spaces removed from the filenames; they complicate scripts and paths for no
    benefit. Content is untouched.
    .gitattributes now marks .3mf binary explicitly, and dedupes the .stl and .f3d
    entries that had been added twice. 3MF is a zip, so text normalisation must
    never touch it.
    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
2026-10-25 Move the 3MF fittings to cad/dust-extraction
    They are shop dust extraction parts, not dust shoe parts - the mitre saw
    adapter in particular has nothing to do with the mill - and they were sitting
    in a folder named stl while not being STLs. Moved with git mv so history
    follows each file.
    Flagged in the new README that solid-brush and body36 may belong back with the
    shoe; both were moved with the rest rather than guessed at.
    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
2026-10-25 solid-brush belongs with the dust shoe; drop body36
    solid-brush.3mf is a shoe part, not an extraction fitting - moved back beside
    shoe-brush.stl. body36.3mf is deleted at Dave's request; it was an
    unidentified 1.7 KB export named after a Fusion body number.
    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
2026-10-25 Rename cad/dust-shoe/stl to print
    The folder stopped being accurate when solid-brush.3mf went in, and the name
    described a format rather than a purpose. print/ says what the files are for,
    which is the real distinction from the .f3d source beside it.
    git mv throughout, so history follows each file. README paths updated.
    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
2026-10-25 All four driver alarms verified individually
    Each encoder unplugged in turn and the axis commanded to move; every driver
    produced fault_pin 1, Stopped by fault_pin, ALARM:13 Hard Stop and Pn:F. So
    all four ALM wires reach the controller - which the healthy input could never
    have told us, since the outputs rest open and four landed wires look identical
    to one.
    That test is now the maintenance task rather than a commissioning step, and
    Pn:F in the status report is the quick way to see whether the input is
    asserted without a meter.
    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
2026-10-25 Plan the E-stop signal via the supply's DC OK contact
    The E-stop cuts mains into the 48 V supply, so the rail decays rather than
    dropping, which rules out a 48 V relay coil - it would not release until the
    rail reached about 20 V. The XDR-960E-48 has a built-in DC OK relay contact
    that opens at roughly 43 V, needs no added parts, and is isolated.
    Records the terminal identification (top two of the 4-way block; the lower pair
    is Parallel Use), the fail-safe polarity with no :low, the continuity check to
    confirm the contact's sense before trusting it, and that the input LED sits lit
    in normal operation.
    estop_pin and fault_pin share a handler, so this is purely so Pn:E and Pn:F
    distinguish w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
2026-10-25 DC OK contact is inverted from the usual - estop_pin needs :low
    Measured: open with the supply on, closed with it off. I had assumed the
    opposite and documented it as fail-safe; it is not. A contact resting open
    cannot report its own broken wire.
    The consequence is mild compared with the driver alarms - a dead signal here
    only returns you to remembering $H by hand, since the E-stop still cuts power
    regardless. Recorded the optocoupler alternative for anyone wanting fail-safe,
    and the startup-alarm race if the 48 V is not up before the board boots.
    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
2026-10-25 Add estop_pin gpio.47:low for the DC OK contact
    Config only - the wire is not run yet. :low because the contact is open when
    the output is good and closed when it is not, measured on the unit rather than
    taken from the symbol.
    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
2026-10-25 estop_pin loses the :low - DC OK is closed when the output is good
    The live pin settles it: with the supply up, gpio.47 signal to GND reads 0 V,
    so the contact is closed while DC is good and the pin rests low. An earlier
    continuity check across the terminals had the two states transposed and sent
    the config the wrong way, which showed up as Pn:E and a startup alarm with
    everything healthy.
    Back to the fail-safe arrangement: a broken wire reads open, the same as a cut
    supply, and alarms.
    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
2026-10-25 E-stop verified: estop_pin gpio.47 from the supply's DC OK contact
    Pressing the E-stop produces estop_pin 1, Stopped by estop_pin, ALARM:13 and
    Pn:E. So $H after an E-stop is enforced rather than remembered - the critical
    alarm only clears with a soft reset, which blocks homing until done.
    Sensing the supply rather than the switch means it also reports a mains
    failure, a blown fuse or an overload shutdown, not just the button.
    Nothing is outstanding now. Replaced the empty Open section with the recurring
    checks that matter: the per-driver alarm test, which is the only way to know
    four ALM wires are still landed, the E-stop press, and the tool setter height.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
2026-10-29 Measure on the setter even when the tool is already loaded
    M6 for the tool already in the spindle returned immediately, so no probe
    ran and no tool length offset was ever set. The usual way in is innocent:
    power up, M61 Q3 to declare what is in the collet, run a program whose
    first tool is 3. Work Z zero then gets touched off with no active offset
    and every tool afterwards is out by the setter constant.
    The bypass now sets #<_rc_bypass>, and the unload and load blocks open
    with an empty "if [#<_rc_bypass> EQ 1]" branch. The magazine trips are
    skipped; the dust shoe park, G43.1 Z0, M61, the setter probe, the shoe
    refit and the return to the starting XY all still run.
    Traced all three paths: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
2026-10-29 Restart the board with [ESP444]RESTART, not $Bye
    deploy.cmd already passed -Restart and deploy.ps1 already had a restart
    branch, but the command it sent could never work. FluidNC's /command
    endpoint only executes commands beginning "[ESP" or "$/"; everything else
    goes to WSChannels::runGCode, which needs a websocket belonging to the
    caller's own HTTP session. curl sends no PAGEID and no session cookie, so
    getWSChannel(0, "") matches nothing and the server answers 500 "WebSocket
    dead". Invoke-Api discarded that with 2>$null and | Out-Null, so the
    script printed "Restarting ..." while the board carried on running --
    visible as the WebUI's "files have changed" notice surviving a deploy.
    $Bye i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
2026-10-29 Do not wait for the restart reply, and keep curl off stderr
    Two faults in the restart added last commit, both found by running it.
    The reply never comes. restart() calls protocol_send_event(&fullResetEvent)
    and the board resets before the HTTP response is flushed, so the request
    dies with "curl: (28) ... 0 bytes received" after the full 15 s. That is
    what success looks like, so the call now gets a 2 s timeout and its result
    is only checked for a refusal, which does answer immediately.
    Worse, that expected timeout killed deploy.ps1 outright. -S makes curl
    write errors to stderr, and in PowerShell 5.1 with $ErrorActionPreference
    = 'Stop' any native stderr becomes a terminating NativeCommandE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
2026-10-29 Stop the deploy when the git pull fails
    deploy.cmd has always pulled -- git pull --ff-only, before it hands off to
    deploy.ps1 -- but it never checked the result. A refused pull printed its
    error and the script carried straight on to upload whatever was on disk,
    which is indistinguishable from a successful deploy of the new files. Local
    commits in the way, a diverged branch, no network and a credential prompt
    all land there.
    It now stops with the reason and uploads nothing, and names the command to
    deploy the working tree deliberately if that was the intent.
    Written "if errorlevel 1" on purpose: inside a parenthesised cmd block
    %ERRORLEVEL% is expanded once at parse time, so "if %ERRORLEVEL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
2026-10-31 Add V1 touch plate on gpio.48 as probe pin; tool setter moves to toolsetter_pin
    FluidNC ORs probe pin and toolsetter_pin, so G38 stops on either and tc.nc
    needs no change. Status shows Pn:P for the plate, Pn:T for the setter.
    Opto block is now full except gpio.3.
    Claude-Session: https://claude.ai/code/session_01DDELjsRwXbVgPc3hx9JvY7
2026-10-31 Add zprobe.nc: Z zero on the work with the 0.5 mm V1 touch plate
    Probes down on gpio.48, lifts slowly until contact breaks, sets work Z to the
    plate thickness there. Run it after M6 so the tool is already measured on the
    setter. Added as macro4 and to both deploy scripts.
    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
2026-10-31 Remove macro4: FluidNC's macros section only has macro0-macro3
    Those four are for control-pin buttons; macro4 is not a valid key. zprobe.nc
    stays in LocalFS and is run from a WebUI macro button instead.
    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
2026-10-31 findzposition.nc: print the real machine Z where the beam clears
    #<_rc_z_pos> was printed but never set. Capture #<_abs_z> after the loop,
    while still in mm, before restoring the caller's units.
    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
